xmejkal/sisuo-brain-transplant/(list of files, drawings)

Other design files:
.tscircuit/cache/pcb_C21190-60b98cc2df22e7e51607d3184a920a28.json
