xmejkal/sisuo-brain-transplant/firmware/micropython/smartbin/power.py

"""
Power policies — "what should the bin do while nothing is happening?"

Staying awake and sleeping deeply are not the same program: deep sleep on this chip is a reset,
so "waking" means booting, asking why, and acting on the answer. All of that is confined here,
behind `PowerPolicy`, and `config.POWER_POLICY` picks one. Nothing else in the firmware knows
which is in use — the lid, the state machine and the sensors are identical either way.

Board and port specifics (wake pins, sleep, watchdog) live in board.py.
"""

from . import board, log, states, timing


class PowerPolicy:
    """
    What the application needs from a power policy:

        trigger_for_wake(smart_bin)     the trigger to fire because of how we booted, or None
        await tick_while_idle(bin)      called repeatedly; may sleep the chip and never return
        sleep_now(smart_bin)            sleep immediately, if this policy can

    Policies may read the bin's state, but must not drive the lid themselves.
    """

    name = "policy"
    sleeps = False

    def trigger_for_wake(self, smart_bin):
        return None

    async def tick_while_idle(self, smart_bin):
        raise NotImplementedError

    def sleep_now(self, smart_bin):
        log.warn("power: %s never sleeps", self.name)
        return False


class StayAwakePolicy(PowerPolicy):
    """
    Never sleeps. What you want on USB, on the bench and while calibrating: the REPL stays alive,
    timing is honest, and nothing reboots underneath you.
    """

    name = "always_on"

    async def tick_while_idle(self, smart_bin):
        await timing.async_sleep_ms(smart_bin.config.IDLE_TICK_MS)


class DeepSleepPolicy(PowerPolicy):
    """
    Sleeps the chip once the bin has been idle, waking on the sensor's interrupt or the OPEN
    button.

    The sensor keeps ranging while the chip is off, so the ESP32's own ~15 uA stops being the
    budget and the sensor's ~170 uA at one reading per second takes over.

    The amplifier used to be the other half of this budget and is no longer. A DFR0534 sat
    permanently on the rail with no enable pin, its class idles somewhere around 15-25 mA,
    nobody had measured it, and if it were anywhere near that figure it was roughly forty times
    everything else put together — so no battery-life claim could be made at all.

    Since 2026-09-25 the audio is a MAX98357A whose shutdown pin the firmware drives: 0.6 uA
    held low, against 340 uA if the clock merely stops, and `hardware.enter_safe_state()` drops
    it before every sleep. That is small enough to disappear beside the sensor, which means the
    sensor is now genuinely the budget rather than one of two unknowns.

    Still measured by nobody, and still the honest caveat on any figure quoted here: the
    sensor's own idle draw, and what the module's regulators cost when nothing is running.

    Requirements this policy checks rather than assumes:
      * the sensor must be able to watch while asleep (`SENSOR_STRATEGY = "tof_interrupt"`);
      * every wake pin must be wake-capable — D0/D1/D2 on this board;
      * every wake source must share the polarity in `config.WAKE_ON_HIGH`, because the chip
        applies one level to all of them. A pull-up button (idle high, pressed low) with
        wake-on-high would wake the instant it slept, forever.
    """

    name = "deep_sleep"
    sleeps = True

    def __init__(self, clock=None):
        self._idle_since_ms = None
        self._clock = clock or timing.Clock()

    # ----------------------------------------------------------------- waking
    def trigger_for_wake(self, smart_bin):
        """Turn the reason we booted into a trigger, so a wake acts immediately."""
        if not board.woke_from_sleep():
            log.info("power: cold boot")
            return None

        gpio_numbers = board.wake_gpio_numbers()
        log.info("power: woken by GPIO %s", gpio_numbers or "(port cannot say)")

        if not gpio_numbers:
            return self._trigger_by_reading_pins(smart_bin)

        if smart_bin.config.PIN_BUTTON_OPEN in gpio_numbers:
            return states.OPEN_PRESSED
        if smart_bin.config.PIN_TOF_INTERRUPT in gpio_numbers:
            smart_bin.sensor.acknowledge_wake()
            return states.HAND_DETECTED
        return None

    def _trigger_by_reading_pins(self, smart_bin):
        """
        Fallback for MicroPython builds that report only *that* we woke, not from which pin:
        look at the pins ourselves. The signal is still asserted this early after a wake.
        """
        if smart_bin.hardware.button_open.is_pressed:
            return states.OPEN_PRESSED
        smart_bin.sensor.acknowledge_wake()
        return states.HAND_DETECTED

    # ----------------------------------------------------------------- sleeping
    async def tick_while_idle(self, smart_bin):
        await timing.async_sleep_ms(smart_bin.config.IDLE_TICK_MS)

        if not self._may_sleep(smart_bin):
            self._idle_since_ms = None
            return

        if self._idle_since_ms is None:
            self._idle_since_ms = self._clock.now_ms()
            return

        idle_for_ms = self._clock.elapsed_ms(self._idle_since_ms)
        if idle_for_ms >= self._sleep_after_ms(smart_bin):
            self.sleep_now(smart_bin)

    def _may_sleep(self, smart_bin):
        """
        A faulted bin sleeps too, just later: blinking red until the cell is flat helps nobody,
        and waking on the button is how the fault gets cleared anyway.
        """
        return smart_bin.lid.state in (states.IDLE, states.FAULT)

    def _sleep_after_ms(self, smart_bin):
        if smart_bin.lid.state == states.FAULT:
            return smart_bin.config.SLEEP_AFTER_FAULT_MS
        return smart_bin.config.SLEEP_AFTER_MS

    def sleep_now(self, smart_bin):
        """
        Put everything in its resting state, arm the wake pins, and stop the chip. Does not
        return — unless it refuses, which it does rather than sleep with no way back.

        A bin that sleeps with nothing able to wake it is dead until someone unplugs it. That is
        a worse outcome than a flat battery, so every reason to refuse is checked here.
        """
        config = smart_bin.config
        sensor_can_wake = smart_bin.sensor.arm_for_sleep()

        if not self._wake_sources_can_assert(smart_bin, sensor_can_wake):
            return False

        smart_bin.hardware.enter_safe_state()
        wake_gpio = self.wake_gpio_numbers(config, smart_bin.sensor)
        log.info("power: sleeping, wake on GPIO %s", wake_gpio)
        board.deep_sleep(wake_gpio, wake_on_high=config.WAKE_ON_HIGH)
        return True

    def _wake_sources_can_assert(self, smart_bin, sensor_can_wake):
        """
        Can anything actually wake this bin?

        The chip applies one polarity to every wake pin, so a source whose asserted level is the
        opposite of `WAKE_ON_HIGH` is not a wake source at all — it is a pin that will sit there.
        A button wired to ground asserts LOW; the sensor's interrupt is configured to match
        whichever polarity is chosen.
        """
        config = smart_bin.config
        button_asserts_high = smart_bin.hardware.button_open.pressed_level == 1

        reasons = []
        if button_asserts_high != config.WAKE_ON_HIGH:
            reasons.append(
                "the OPEN button asserts %s but wake is armed for %s"
                % ("HIGH" if button_asserts_high else "LOW",
                   "HIGH" if config.WAKE_ON_HIGH else "LOW")
            )
        if not sensor_can_wake:
            reasons.append("the sensor cannot watch while asleep (%s)" % config.SENSOR_STRATEGY)

        if len(reasons) > 1 or (reasons and not sensor_can_wake and button_asserts_high != config.WAKE_ON_HIGH):
            log.error("power: refusing to sleep, nothing could wake the bin: %s", "; ".join(reasons))
            return False
        for reason in reasons:
            log.warn("power: %s", reason)
        return True

    @staticmethod
    def wake_gpio_numbers(config, sensor):
        """Which pins are armed. Separate from `sleep_now` so a test or the REPL can check it."""
        numbers = [config.PIN_BUTTON_OPEN]
        if sensor.watches_while_asleep:
            numbers.append(config.PIN_TOF_INTERRUPT)
        board.assert_wake_capable(numbers)
        return numbers


POLICIES = {
    StayAwakePolicy.name: StayAwakePolicy,
    DeepSleepPolicy.name: DeepSleepPolicy,
}


def build_policy(config):
    """The strategy choice, from one config line. An unknown name stays awake, loudly."""
    policy_class = POLICIES.get(config.POWER_POLICY)
    if policy_class is None:
        log.warn("unknown power policy %r; staying awake", config.POWER_POLICY)
        return StayAwakePolicy()
    return policy_class()
