xmejkal/sisuo-brain-transplant/firmware/micropython/smartbin/close_detection.py

"""
Close detection — "is the lid actually shut?"

This is the question the original Sisuo board got wrong: it drove the lid closed and waited
forever for a confirmation that never came. `CloseDetector` is the question; the three
implementations are increasingly good answers, chosen by `config.CLOSE_DETECTOR`.

None of them is the safety net. `Lid` stops the motor at `MOTOR_MAX_RUN_MS` regardless of what a
detector says, so a broken detector can never burn the motor.
"""

from . import log


class CloseDetector:
    """
    What the lid needs to know whether a closing stroke has finished:

        start()                called as the closing stroke begins
        is_closed(elapsed_ms)  True when the lid should be considered shut;
                               `elapsed_ms` is measured from the start of that stroke
    """

    def start(self):
        """Reset any per-stroke state. Detectors with none may do nothing."""

    def is_closed(self, elapsed_ms):
        raise NotImplementedError


class TimedCloseDetector(CloseDetector):
    """
    Run the motor for a calibrated time and call it shut. No extra hardware, no feedback.

    Good enough to get the bin working, and the reason `LID_CLOSE_RUN_MS` needs calibrating on
    the bench. It cannot tell "shut" from "jammed on a bin bag" — that is what the safety cap and
    the OBSTRUCTED state are for.
    """

    def __init__(self, run_ms):
        self._run_ms = run_ms

    def is_closed(self, elapsed_ms):
        return elapsed_ms >= self._run_ms


class LimitSwitchCloseDetector(CloseDetector):
    """
    A microswitch at the end of travel: deterministic, no calibration, and "shut" means shut.
    One extra part, and the option the electronics review preferred.

    The switch is wired to ground with a pull-up, so a closed switch reads 0.
    """

    def __init__(self, pin):
        self._pin = pin

    def is_closed(self, elapsed_ms):
        return self._pin.value() == 0


class MotorStallCloseDetector(CloseDetector):
    """
    Watch the motor current and call the lid shut when it stalls against its stop — the method
    the original board appears to have used.

    Needs the 1 ohm shunt in the motor's ground return and an ADC pin (only GPIO0/1/2 have one on
    this chip). Readings are averaged because the ESP32-C6's ADC is noisy, and the first
    `blanking_ms` of a stroke are ignored so the motor's inrush current is not read as a stall.

    `consecutive_hits` counts polls rather than time, so it depends on `MOTION_POLL_MS`; at the
    default 10 ms, 3 hits is about 30 ms of sustained over-current.
    """

    def __init__(self, adc, stall_counts, blanking_ms=200, samples=8, consecutive_hits=3):
        self._adc = adc
        self._stall_counts = stall_counts
        self._blanking_ms = blanking_ms
        self._samples = samples
        self._consecutive_hits = consecutive_hits
        self._hits = 0

    def start(self):
        self._hits = 0

    def read_counts(self):
        """Averaged raw ADC counts. Public because calibration reads it from the REPL."""
        total = 0
        for _ in range(self._samples):
            total += self._adc.read_u16()
        return total // self._samples

    def is_closed(self, elapsed_ms):
        if elapsed_ms < self._blanking_ms:
            return False

        counts = self.read_counts()
        if counts < self._stall_counts:
            self._hits = 0
            return False

        self._hits += 1
        if self._hits < self._consecutive_hits:
            return False

        log.info("stall detected at %d counts after %d ms", counts, elapsed_ms)
        return True
