xmejkal/sisuo-brain-transplant/tools/build-flash-image.py

#!/usr/bin/env python3
"""
Build a flash image containing MicroPython *and* our firmware, for headless simulation.

The problem this solves: Wokwi's CLI simulates a flash image, and the MicroPython download is
only the interpreter. On real hardware you copy your .py files over USB afterwards; a headless
simulator has no "afterwards". So the files have to already be in the image.

MicroPython's ESP32 partition table stops after `factory`, and the comment in its own
partitions-4MiBplus.csv says the rest of the flash is the user filesystem — so the filesystem
starts at 0x200000 and runs to the end of a 4 MB flash. This writes a littlefs image of our
firmware there and concatenates the two.

    python3 tools/build-flash-image.py
    python3 tools/build-flash-image.py --config '{"POWER_POLICY": "deep_sleep"}' other.bin

The second form writes a /config.json into the image, which is how a differently-configured bin
is simulated without editing config.py.

The littlefs parameters are the ones MicroPython's ESP32 port uses. If they are wrong the
simulated board boots to a bare REPL with no main.py, which is the symptom to look for.
"""

import json
import sys
from pathlib import Path

from littlefs import LittleFS

REPO = Path(__file__).resolve().parent.parent
FIRMWARE = REPO / "firmware" / "micropython"
SIM = FIRMWARE / "sim"

# The active board, as spark's boards.py resolved and validated it — the same file
# tools/generate-board-spec.py reads. This imported spark's `boards` to ask two questions the
# resolved file already answers, which made the image builder, and the gate that imports it,
# unable to run anywhere spark is not: CI, which cannot reach the private plugin (spark B7).
RESOLVED_BOARD = json.loads((REPO / ".spark" / "board.json").read_text())

# Named after the chip, not hard-coded: the Makefile guards this target on a file called
# micropython-<chip>.bin, and a constant here that named a different chip made the guard pass
# and the script then fail looking for the previous board's build. Which is exactly what
# happened when the board changed from an ESP32-C6 to an S3.
MICROPYTHON_IMAGE = SIM / ("micropython-%s.bin" % RESOLVED_BOARD["chip"])
MICROPYTHON_PORT = RESOLVED_BOARD["micropython_port"]
OUTPUT_IMAGE = SIM / "flash-with-firmware.bin"

# Settings written into /config.json inside the image. Only keys in config.CALIBRATABLE are
# accepted by the firmware.
#
# The MAIN simulation image is the BENCH configuration: awake, polling the rangefinder over I2C.
# This was `{}` until 2026-09-25, which inherited config.py's deployed defaults — deep_sleep and
# tof_interrupt — so the bin under test slept and let the sensor range by itself. Two scenarios
# could therefore never pass, and never had: `wave-to-open` and `obstruction` both drive the
# sensor's distance control and wait for the lid to react, which a sleeping bin with a
# self-ranging sensor does not do. Both timed out at "smartbin ready" for the life of the file.
#
# The battery configuration is not lost: it has its own image and its own project directory,
# because a wokwi.toml names exactly one firmware. See sim/deep-sleep/.
CONFIG_OVERRIDES: dict = {"POWER_POLICY": "always_on", "SENSOR_STRATEGY": "tof"}

FLASH_SIZE = 4 * 1024 * 1024        # the XIAO ESP32-C6 has 4 MB
FILESYSTEM_OFFSET = 0x200000        # where MicroPython looks, per partitions-4MiBplus.csv
BLOCK_SIZE = 4096

# MicroPython's own littlefs2 settings, read from its source rather than guessed:
#   extmod/vfs_lfs.c   readsize / progsize / lookahead all default to 32
#   extmod/vfs_lfsx.c  cache_size = min(block_size, 4 * max(read, prog)) = 128, block_cycles = 100
# These must match or the board mounts nothing, boots to a bare REPL, and never runs main.py.
LITTLEFS_SETTINGS = dict(
    block_size=BLOCK_SIZE,
    read_size=32,
    prog_size=32,
    cache_size=4 * 32,
    lookahead_size=32,
    block_cycles=100,
    disk_version=0x00020000,        # littlefs 2.0, which MicroPython writes
)

# What goes on the simulated board: the package, its configuration, and the two boot files.
def files_to_include():
    yield from sorted((FIRMWARE / "smartbin").glob("*.py"))
    yield FIRMWARE / "config.py"
    yield FIRMWARE / "main.py"
    yield FIRMWARE / "boot.py"


def build_filesystem(overrides: dict) -> bytes:
    block_count = (FLASH_SIZE - FILESYSTEM_OFFSET) // BLOCK_SIZE
    filesystem = LittleFS(block_count=block_count, **LITTLEFS_SETTINGS)
    filesystem.mkdir("/smartbin")

    total = 0
    for source in files_to_include():
        destination = (
            f"/smartbin/{source.name}" if source.parent.name == "smartbin" else f"/{source.name}"
        )
        content = source.read_bytes()
        with filesystem.open(destination, "wb") as handle:
            handle.write(content)
        total += len(content)
        print(f"  {destination:<28} {len(content):>6} bytes")

    if overrides:
        content = json.dumps(overrides).encode()
        with filesystem.open("/config.json", "wb") as handle:
            handle.write(content)
        total += len(content)
        print(f"  {'/config.json':<28} {len(content):>6} bytes  {overrides}")

    print(f"  {'':<28} {total:>6} bytes in {block_count} blocks of {BLOCK_SIZE}")
    return filesystem.context.buffer


def main() -> int:
    if not MICROPYTHON_IMAGE.exists():
        print(f"missing {MICROPYTHON_IMAGE}")
        print("download a build from https://micropython.org/download/%s/" % MICROPYTHON_PORT)
        return 1

    overrides = dict(CONFIG_OVERRIDES)
    output = OUTPUT_IMAGE
    arguments = sys.argv[1:]
    if "--config" in arguments:
        index = arguments.index("--config")
        overrides = json.loads(arguments[index + 1])
        output = SIM / arguments[index + 2] if len(arguments) > index + 2 else OUTPUT_IMAGE

    print("firmware files:")
    filesystem = build_filesystem(overrides)

    interpreter = MICROPYTHON_IMAGE.read_bytes()
    if len(interpreter) > FILESYSTEM_OFFSET:
        print(f"the MicroPython image is larger than {FILESYSTEM_OFFSET:#x}; it would be overwritten")
        return 1

    image = bytearray(b"\xff" * FLASH_SIZE)
    image[: len(interpreter)] = interpreter
    image[FILESYSTEM_OFFSET : FILESYSTEM_OFFSET + len(filesystem)] = filesystem
    output.write_bytes(image)

    print(
        f"\nwrote {output.relative_to(REPO)}: "
        f"{len(image) // 1024} KB "
        f"(MicroPython to {len(interpreter):#x}, filesystem at {FILESYSTEM_OFFSET:#x})"
    )
    return 0


if __name__ == "__main__":
    sys.exit(main())
