xmejkal/sisuo-brain-transplant/(commit log)

2026-09-22 Smart bin: routed board (real parts) + firmware + docs + parts reference
    [oled_ssd1306.obj, pcb_C14663-2a524d5328448d9a4ab8c2511452e7b5.json, pcb_C23162-1be90e176d4cbb49a1eca76dfaf2f7c9.json, tactile_button_6mm.obj]
2026-09-23 Firmware v2: MicroPython state machine, strategies, tests
    Replaces the v1 timed loop with an OO package built around an explicit state
    machine, after a MicroPython/ESP32 architecture review and a digital-electronics
    review of the planned hardware.
    - states.py holds states, triggers and the transition table - behaviour as data,
    so obstruction handling (reopen, retry, then latch a fault) is readable and
    testable. The original bin's fault was retrying a close forever.
    - Strategy pattern where the hardware is undecided: proximity sensing (VL6180X
    ToF / IR burst / buttons only) and close detection (timed / limit switch /
    stall). Both chosen in config.py.
    - Events are "entered:<state>", p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
    [01_board_alive.py, 02_inputs.py, 03_tof.py, 05_motor.py, app.py, audio.py, boot.py, config.py]
2026-09-23 Deep sleep support: power policies, interrupt-driven ToF, new pin map
    Adds the seam that makes "polling vs interrupts vs deep sleep" a config line
    instead of a rewrite, after verifying what the C6 actually supports.
    - power.py: AlwaysOnPolicy (bench/USB) and DeepSleepPolicy, behind prepare()/
    idle(). Waking from deep sleep is a reset, so prepare() converts the wake pin
    into a trigger and the hand that woke the bin does not wave twice.
    - sensors.TofInterruptSensor: the VL6180X ranges continuously on its own clock
    and asserts GPIO1 below a threshold, so the CPU can be off entirely. While
    awake it reads the pin rather than the I2C bus.
    - vl6180x: configure_interrupt/start_continuous/cl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
    [02_inputs.py, 03_tof.py, app.py, config.py, power.py, sensors.py, vl6180x.py]
2026-09-23 Audit fixes: self-cancelling tasks, sensor errors, naming, calibration
    A four-way review (correctness, readability, architecture, on-device
    practicality) went through the firmware. The critical finding first.
    CRITICAL: MicroPython raises RuntimeError("can't cancel self") when a task
    cancels itself, and every stroke does exactly that - it fires the trigger that
    transitions the lid away, and the exit hook cancels the running stroke. The lid
    would have opened once and frozen forever, with the machine stuck mid-transition.
    Fixed in lid._cancel_safely; the test fakes now model the RuntimeError instead of
    swallowing it, and a new test runs the real lid against real asyncio, because a
    model of asy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
    [app.py, audio.py, boot.py, config.py, events.py, factory.py, fakes.py]
2026-09-23 Make smartbin/__init__.py the guided tour of the firmware
    The entry path was spread across four files, so "how does this work" had no
    single answer. The package docstring is now the tour: what each part is, a
    diagram of how they connect, and the end-to-end walkthrough of a hand wave
    through sensor, trigger, table, hook, stroke and feedback.
    build() reads top to bottom as the assembly itself - peripherals, then the three
    swappable decisions, then the things that react, then the object that runs it.
    app.py -> smart_bin.py, since it defines SmartBin, and main.py and the README now
    point at the tour.
    [main.py, smart_bin.py]
2026-09-23 Sort the layering: devices in hardware, decisions in strategies
    "Why is the motor hardware but the sensor is not?" had no good answer, because
    the rule was never stated and had drifted: hardware held some device objects
    (motor, player, buttons) and some raw pins, while the VL6180X driver - a device
    by any reading - was constructed in factory.py next to the strategy choices.
    The rule now: a DEVICE is a thing you command, a STRATEGY is a decision you make
    with it. So the rangefinder chip sits in hardware.py beside the motor, and "is
    that a hand?" stays in sensors.py, because which judgement you want is a config
    choice and the chip is not.
    - hardware.py builds the rangefinder (with its calibr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
    [factory.py, hardware.py, test_factory.py]
2026-09-23 Rename modules for clarity; one composition root
    Names now say the job rather than the pattern or the acronym, and "how is a bin
    assembled" has a single answer.
    factory.py -> assembly.py (names the job; now also holds build/run)
    fsm.py -> state_machine.py (no acronyms)
    ui.py -> buttons.py + status_led.py (there is no UI; two devices, two files)
    closing.py -> close_detection.py (a gerund that read like shutdown)
    compat.py -> timing.py (ticks, clocks and sleeps, not miscellany)
    platform.py -> board.py (platform shadows a stdlib module - a real trap)
    sensors.py -> proximity.py (says what it senses)
    build() and run()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
2026-09-23 Testing: a fake machine module, and Wokwi simulation scaffolding
    Two new layers between the unit tests and the bench.
    tests/fake_machine.py stands in for MicroPython's machine and esp32 modules, so
    hardware.py, the VL6180X driver's register conversation and the real asyncio
    tasks all run on the Mac. test_on_fake_hardware.py uses it to press a button and
    watch the motor pins, wave a hand past a fake rangefinder, assert that
    constructing the bin never moves the lid, and check that deep sleep arms the
    right wake pins and stops the motor first. 58 tests now, still under two seconds.
    sim/ holds the Wokwi setup. Researched and verified: Wokwi supports the ESP32-C6
    and the XIAO ESP32-C6 is a stoc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
2026-09-23 Simulate on MicroPython, and fix the bug it found
    sim/run_on_micropython.py runs the whole firmware on a real MicroPython runtime
    (brew install micropython) with tests/fake_machine.py underneath it: it presses
    the buttons, waves a hand at the rangefinder, holds something in the lid's way,
    and checks what the bin does. Twelve checks, exit code says pass or fail, no
    account and no cloud. Every module also compiles clean under mpy-cross, which is
    MicroPython's own compiler.
    It found a real bug on its first run. A hand that never leaves re-armed the hold
    timer forever - "a hand in the way keeps the lid open" was deliberate, but nothing
    capped the total, so anything parked in front of the sensor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
    [config.py, fakes.py, lid.py, state_machine.py, test_integration.py, test_lid.py]
2026-09-23 Add a README for the repository
    Written for someone landing on the project cold: what it is, what is proven and
    what is not, how the lid behaves, and how to run the tests and the simulation.
2026-09-23 Wokwi: custom chips for the parts it has no model of
    Wokwi has no time-of-flight sensor and no H-bridge, which are exactly the two
    parts the bin's behaviour depends on, so both are now written as custom chips in
    C and compile to WASM with wokwi-cli.
    - vl6180x.chip.c answers I2C at 0x29 with the registers smartbin/vl6180x.py
    actually reads: model ID, fresh-out-of-reset, sample-ready, range and status.
    The measured distance comes from a slider you can drag mid-simulation, and the
    interrupt pin asserts below the threshold the firmware sets - so the wake-on-
    hand path is simulable too.
    - l9110s.chip.c watches the driver's two inputs and prints MOTOR: opening /
    closing / stopped, which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
    [l9110s.chip.c, vl6180x.chip.c]
2026-09-23 Plan the conversion pipeline from circuit.json to other formats
    Researched what a standard interchange format actually is (there isn't one),
    what already exists (a lot, from tscircuit and kicad-cli) and what has to be
    written (only the Wokwi converter - nothing anywhere converts an EDA format to
    diagram.json).
    The design: circuit.json stays the pivot, a thin logical netlist is the one
    shared abstraction, and every target is a pure emitter reading it. Connectivity
    is read one way only, through the precomputed subcircuit_connectivity_map_key
    that every source_port already carries. Anything mature is delegated to KiCad,
    so we maintain two converters instead of six.
    Also records what must stay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
2026-09-23 Build circuit-to-wokwi: generate the simulation from the board design
    Nothing converts an EDA format to Wokwi's diagram.json, so this does. The design
    is the one planned in FORMATS.md: circuit.json -> a thin Netlist -> emitters,
    with the mapping table as data and connectivity read only through
    circuit-json-to-connectivity-map, never re-derived.
    What research changed:
    - @wokwi/diagram-lint bundles Wokwi's own registry of 137 parts with real pin
    lists, so pin names are checked offline rather than guessed. It immediately
    caught board-ssd1306 using SDA/SCL where I had written DATA/CLK.
    - Custom chips are in neither that registry nor wokwi-cli lint, so the oracle
    also reads our chip.json f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
2026-09-23 Board v2, and a Makefile so everything derived stays derived
    The board was the odd one out: board.tsx still described the v1 design (TB6612,
    OLED, old pin map) while the firmware and the simulation had moved on. It now
    describes what the firmware expects - L9110S, a time-of-flight rangefinder on
    I2C, a bicolour status LED, no OLED, and the v2 pin map that keeps the sensor
    interrupt, the OPEN button and the one ADC on D0/D1/D2, the only pins that can
    wake an ESP32-C6. It builds and routes clean: 45 traces, no errors. The v1 design
    is kept as board-v1-tb6612.tsx.
    Also on the board now, from the electronics review: 10k pulldowns holding the
    motor still while the board boots, a 1 ohm low-side s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
    [pcb_C23138-15214603cfbb15bb8920109fa7e6863a.json, pcb_C25271-413a824410202a5aed057ecaefafa0a3.json, pcb_C25804-fb8d950806824786da1b1e4ced4e126a.json]
2026-09-23 The generated diagram is now the diagram the simulator loads
    It was being written to diagram.generated.json beside a hand-written
    diagram.json, and Wokwi loads diagram.json - so the generated file was doing
    nothing and the two could disagree freely, which is the exact failure this tool
    exists to prevent.
    Now board.tsx generates sim/diagram.json itself. The hand-written version is in
    git history; its layout is not carried over because the part ids come from the
    design (BtnOpen -> btnopen), and from here on merge.ts preserves any positions
    tuned in the editor.
    The scenario file follows the same ids. Verified: the result passes Wokwi's own
    wokwi-cli lint, wires all eight parts including both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
2026-09-23 Verify the two facts the first simulation run depends on
    Both were guesses; both are now read from source rather than assumed.
    littlefs: MicroPython's defaults are readsize/progsize/lookahead = 32
    (extmod/vfs_lfs.c) and cache_size = min(block_size, 4*max(read, prog)) = 128 with
    block_cycles = 100 (extmod/vfs_lfsx.c). That is exactly what the image builder
    uses, so the "boots to a bare REPL with no main.py" failure is now unlikely
    rather than merely hoped against. The reference is in the file so nobody
    re-derives it.
    set-control: the current field is `name`, and the docs still show `control`,
    which the CLI accepts as a deprecated alias
    (packages/cli/src/scenario/SetControlCommand.ts). The s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
    [build-flash-image.py]
2026-09-23 The simulation runs: a press drives a full lid cycle
    make simulate now exits 0 with "Scenario completed successfully". Our MicroPython
    firmware boots on a simulated ESP32-C6 from the flash image we build, a simulated
    button press opens the lid, the motor chip reports it turning, the hold expires,
    and it closes itself. The strokes measured 912 ms and 951 ms against the 900 and
    950 configured.
    Four things were wrong, each costing one run:
    - wait-serial watches the MCU's serial only. A custom chip's printf goes to a
    separate stream, shown prefixed, and can never match a wait-serial. Two of the
    failures were exactly this, on MOTOR: lines.
    - a wait only sees text arriving after its step beg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
    [l9110s.chip.c]
2026-09-23 One file describes the board; everything else derives from it
    "Is changing the ESP easy and in one place?" It was not: the silkscreen-to-GPIO
    map, the wake-capable pins, the Wokwi part type and the board's size lived in six
    places across the firmware, the PCB design, the converter and two checkers. Six
    copies of a fact are five chances to be wrong.
    boards/xiao-esp32-c6.json is now the single description: pins, wake-capable
    GPIOs, ADC pins, pins with a second job, the deep-sleep API this chip actually
    has, and - because a board swap has to refresh the shape too - its footprint,
    outline and on-screen size.
    Derived from it: the firmware's board_spec.py (generated; make check fails when
    stale)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
    [board.py, build-flash-image.py, generate-board-spec.py, vl6180x.chip.c]
2026-09-23 Make the checks able to fail, and stop committing 12 MB of binaries
    An audit found the headline guarantee was false: `make check` could not fail on
    the two checks that compare the firmware, the board and the simulation. Both
    recipes ended in `| tail -1`, and a shell reports only the last command's status,
    so a failing check printed its complaint and then "everything is in step" with
    exit 0. CI and the pre-commit hook waved it through.
    .SHELLFLAGS with pipefail would fix it on GNU make 3.82+; macOS ships 3.81, which
    ignores it. So every gating recipe now runs bare, captures output to a file, and
    prints from there - the pattern the test steps already used.
    Verified by breaking things on purp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
2026-09-23 Safety fixes from the audit: wake polarity, config validation, task supervision
    Three findings that would have cost a bench day each, and a fourth that would
    have cost the battery.
    The OPEN button could never have woken the bin. The board wires both buttons to
    ground, so they assert LOW, while the firmware armed ext1 for a HIGH and pulled
    the pin down - a pin held low, waiting to go high. Worse, two tests asserted the
    two halves of that contradiction and both passed. The board now owns the
    polarity (boards/*.json), the button carries its own pressed_level, and the power
    policy refuses to sleep when nothing armed could assert the level that wakes -
    because a bin asleep with no way back is wo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
    [buttons.py, config.py, lid.py, power.py, smart_bin.py, test_on_fake_hardware.py]
2026-09-23 Converter: stop parts vanishing, and let the mapping own its attributes
    Two holes the audit opened with a screwdriver.
    Unanchored skip patterns swallowed parts they were never meant to. /Power/
    matched a component renamed from StatusLed to PowerLed, and the status LED left
    the simulation in silence with "the simulator powers the board itself" - exit 0,
    coverage clean. Every skip rule is now anchored to whole component names, and a
    new check requires every component in the design to become a part, a stated
    omission or a reported problem. Verified with the same rename: it now fails.
    Attributes were write-once. merge.ts let the committed file's attrs override the
    generated ones, so changing a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
2026-09-23 Documentation sweep: make every claim true
    An audit checked every factual claim in the docs against the code and found the
    project describing itself as it was two days ago. The worst of it:
    - README and STATUS said the PCB was still v1 (TB6612, OLED, old pin map). It is
    v2, routed, 45 traces, 0 errors, and matches the firmware pin for pin.
    - STATUS said the Wokwi project had never been run, three commits after it ran
    and four scenarios passed.
    - The chips README said "not written yet" about two chips that are compiled and
    in use - and said nothing about how they diverge from the real parts, which is
    what a reader actually needs.
    - CLAUDE.md carried a v1 pin map alongside the v2 one,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
2026-09-23 An empty room is not a broken sensor
    The firmware counted a routine measurement error toward its failure budget. An
    empty field of view produces one every time - the driver's own docstring says so -
    so a bin nobody was using would have faulted after ten polls, about six hundred
    milliseconds, and sat there with a red LED until someone pressed a button.
    Nothing caught it because both fakes always reported a good reading. Now they can
    fail in both ways, and the two cases are distinguished: a measurement error means
    "no hand" and resets the count, while a silent bus escalates to a fault after ten
    tries, because a cable that comes out must be noticed.
    Sixteen new tests, covering what the audit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
    [fake_machine.py, proximity.py, test_audio_and_feedback.py, test_sensor_failure.py]
2026-09-23 Board and simulator fixes: sense filter, and a chip that can fail
    The remaining audit findings.
    The pulldowns on the motor inputs returned to system ground while the driver's
    own ground sits a shunt-drop above it - so while the motor ran, the "low" the
    driver saw was negative with respect to its own ground, outside its input range
    and an injection path into the chip. They now return to the driver's ground.
    The shunt is 0.33 ohm rather than 1: it still gives ~76 mV at the stall the
    literature predicts, comfortably above this ADC's noise, while costing the motor
    a third of the voltage. The sense line reaches the pin through 1k and 100nF,
    which limits current into the pin if the motor ever st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
    [pcb_C21190-60b98cc2df22e7e51607d3184a920a28.json]
2026-09-23 Tests and harnesses pin the configuration they describe
    Found by asking the obvious question: what happens if someone changes the sensor?
    Switching SENSOR_STRATEGY to "ir" - one line, exactly the seam the strategies
    exist for - broke seven tests and the MicroPython harness. Not because the
    firmware minded, but because those files copied whatever config.py shipped with
    and then asserted things about the rangefinder. A file that tests the
    time-of-flight build should say so, not inherit it.
    They now pin SENSOR_STRATEGY, CLOSE_DETECTOR and POWER_POLICY explicitly.
    Changing the shipped default no longer makes them fail; it makes them irrelevant,
    which is what a test about a different build shou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
    [test_on_fake_hardware.py, test_sensor_failure.py]
2026-09-23 Real module bodies, and only for what is really on the board
    The board carried real footprints but nothing said how big the things that plug into them
    are. A six-pin header is 15 x 2.5 mm; the driver that sits on it is 29 x 23 and stands 12 mm
    tall. So every module now carries a 3D body at its true size — vendor STEP where one exists
    (L9110S, CC0), the vendor's own dimension drawing where it does not (DFR0534, 30 x 22 mm),
    and the module outline for the XIAO, which Seeed publish no model for.
    That immediately showed eight collisions and four parts hanging off the edge, none of which
    any PCB check had objected to, because pads were never the constraint.
    The fix was not a bigger board. Two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
    [check-module-clearance.py]
2026-09-23 A bring-up step that runs the whole bin, and is itself checked
    Steps 1 to 5 prove one part each; nothing proved the assembled bin until you deployed the
    firmware and improvised at the REPL. Step 6 is that missing step, written down: it runs the
    real build() with the real strategies, does a roll call of every fitted device before anything
    moves, then asks for a wave, an OPEN press and a MODE press, and reports which of the three
    ways in worked. Per-phase, because "it doesn't work" is not a useful bench result.
    The script is checked off the bench. tests/test_bringup.py runs it against the fake chip with
    a stand-in for the person, supplying only the stimulus each phase asks for — so a "wave"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
    [06_all_together.py, test_bringup.py]
2026-09-23 Documentation: make the counts true again
    80 tests not 79, 13 MicroPython checks not 12 (make counted 13 while three documents said
    12), 48 traces not 45, and the handover note now ends the bring-up list where it actually
    ends: at step 6, the acceptance test.
2026-09-24 Three defects an expert audit found, two of which stop the bin working
    A council of reviewers was asked to audit a plan for a new plugin. The plan did not survive,
    but the audit found something better: three defects in this design, sitting in a repo where
    every generated artifact agreed with every other one.
    **The battery did not power the MCU.** LipoBattery.POS went to net.VBAT, and VBAT reached the
    MP3 module, its reservoir cap and its decoupling cap — and nothing else. CLAUDE.md has said
    "logic+audio on a LiPo (XIAO BAT pads)" since v2 was designed. The intent was recorded, the
    trace never existed. On battery the ESP32 had no power at all.
    The pads are pin23/pin24 of the footprint, un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
2026-09-24 Board pin roles: typed for programs, noted for people
    `special` was a free-text map — `"16": "U0TXD - the ROM bootloader prints its log here on every
    reset. Safe for a button, never for a module that parses serial."` That sentence contains a real
    design rule, and no program could ever act on it. Only the keys were machine-readable, and only
    one checker used them, as a bare set of numbers.
    It is now `pin_roles`: named roles (`boot_log_tx`, `onboard_led`), each with a `gpio` array a
    check can read and the note kept intact for whoever is reading the file. The spark plugin's new
    pin check uses it to fail a UART module placed on the boot-log pin while still allowing a button
    there, which is th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
    [generate-board-spec.py]
2026-09-24 L9110S input thresholds: measured off the datasheet, and what they cost
    The audit flagged a question it could not answer: the L9110S runs on 6 V and its inputs are
    driven from 3.3 V GPIO, so if its input-high threshold were ratiometric (0.7 x VCC = 4.2 V) the
    motor would never turn. Pulled the datasheet and read the table: VH in is 2.5 V min, 5.0 typ,
    9.0 max — an absolute voltage. 3.3 V logic drives it. The worry does not apply to this part.
    But the same numbers expose something the design does have to live with. The driver's ground
    sits on net.MOTOR_SENSE, above system ground by I x 0.33 R, and the chip judges its inputs
    against its own ground. So the effective input high is 3.3 - 0.33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
2026-09-24 Stop the docs promising a battery life nobody has measured
    Two files told you, after a break, that this bin runs for months on a 1000 mAh cell:
    smartbin/power.py's DeepSleepPolicy docstring and firmware/micropython/README.md. Both arrive at
    that by budgeting only the parts the sleep policy can switch off — the sensor at ~170 uA and the
    ESP32 at ~15 uA — and neither mentions the DFR0534.
    The MP3 module sits on VBAT permanently with no enable pin. Its class idles somewhere around
    15-25 mA, which would be roughly forty times everything else on the board put together, and would
    make both statements wrong by a similar factor. Nobody has measured this one, so the honest
    position is that the b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
    [audio.py, power.py]
2026-09-24 The bin gets a brief and a findings file
    .spark/project.json says what this thing must do — a month on a charge, fit the original cavity,
    open within half a second — plus what is already decided, so a reviewer stops relitigating the
    L9110S and the missing OLED. The `must` list is what turns a number into a finding: "15 mA idle"
    is a measurement, "15 mA idle against a stated one-month requirement" is something to act on.
    .spark/findings.json carries the two real findings the reviews have produced so far: the
    always-powered MP3 module, and the 0.33R shunt in an 0805 whose 0.125 W rating caps it around
    0.61 A — which the motor may well exceed at stall, in the driver's own ground return.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
2026-09-24 Remove a measurement nobody took
    18.4 mA sat in this project's findings store as the MP3 module's idle current, with an
    instrument and a date, looking exactly like a reading. It was the example value out of the
    plugin's own documentation, pasted in while demonstrating the tool. STATUS.md item 6 correctly
    said the number had never been measured; the store disagreed and the store looked authoritative.
    Both findings go back to blocked, which is what they are.
2026-09-24 Tie the motor driver's unused channel down
    A comparator reading the built netlist reported MotorDriver.BIA and BIB connected to nothing.
    Channel B is unused — one motor, one channel — but its inputs are still inputs on a chip that is
    powered, and a floating CMOS input has no defined level. It drifts, and on an H-bridge an
    undefined input is how both halves of a bridge end up conducting at once.
    Tied to the driver's own ground rather than the board's, matching what the channel A pulldowns
    already do: the shunt lifts the driver's GND above system ground, so an input judged against
    system ground is judged against the wrong reference. Both inputs low is the L9110's coast state,
    which is wha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
2026-09-24 Choose the board in one place, and enforce a contract on it
    boards/active.json now names the active board and nothing else does.
    The Makefile, the firmware's board-spec generator and the simulator's
    diagram generator all resolve through tools/boards.py, which also
    enforces a contract: a board file that breaks it is refused rather than
    read optimistically, because the failure mode of guessing is a wrong
    pin map and that is silent until the hardware is built.
    --validate --for-fab is kept separate and gates gerber export, so
    firmware work proceeds on a board whose footprint nobody has verified
    while an unverified footprint cannot reach a fab file.
    The contract also mechanises the rule boards/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
    [generate-board-spec.py]
2026-09-24 A FireBeetle footprint, generated rather than downloaded
    Every pin position on this module is an obround pad: a through-hole
    1.27 mm inboard of the edge, plus a castellated half-hole centred ON
    the edge. Measure the outer circles and the rows are 25.40 mm apart;
    measure the holes a header actually solders into and they are 22.86 mm.
    At least one public KiCad footprint for this board uses the former, and
    a header fitted to that will not mate. Generating it from DFRobot's
    dimension drawing makes that distinction explicit and reviewable.
    Two mistakes this file now records rather than repeats. The drill was
    0.9 mm, copied straight from DFRobot's drawing — but that is THEIR
    finished hole for T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
    [generate-firebeetle-footprint.py]
2026-09-24 Board v3: the FireBeetle, and what a review found on it
    100 x 62 mm. The module alone is 25.4 x 60 and runs the whole left
    half, which is why the outline grew twice: at 45 mm the two plug-in
    modules stacked to exactly the board height, and at 50 mm there was no
    corner a mounting hole could go in without landing under the module.
    The LiPo now plugs into the module's own socket, so the battery
    connector and the XIAO's BAT-pad polarity question are both gone. There
    is no VBAT rail: the module's 3V3 is a TPS62A02 buck good for 2 A, and
    the MP3 sat on VBAT only because the XIAO's LDO could not take audio
    transients.
    What a four-reviewer pass changed, in order of what it would have cost:
    - 22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
2026-09-24 Firmware for the S3: a new pin map, a switched amplifier, and a crash
    The C6 could wake from three usable pins and the whole map was bent
    around them. The S3 has 22, so pins are spent on purpose: the two that
    must wake the bin take RTC pins that are NOT on ADC1, so they cost no
    analogue headroom; the two that never wake take the non-RTC pins; both
    strapping pins are left empty, because a button on GPIO0 held during a
    reset drops the board into the bootloader.
    Deep sleep is the shipped default, with tof_interrupt alongside it —
    they only work together, because a sleeping chip cannot poll a bus.
    A real crash, on the shipped sensor path: SelfRangingTimeOfFlightSensor
    called _note_failure, w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
    [board.py, config.py, hardware.py, proximity.py, smart_bin.py]
2026-09-24 Checks that can fail, for four that could not
    make check said "firmware, board, bench scripts and simulation all
    describe the same bin" while four categories of board-specific fact had
    rotted. Every one of them was internally consistent, which is precisely
    the property those checks were measuring.
    - Every expect-pin in the Wokwi suite addressed part-id: xiao on a
    diagram whose board is now mcu with pins named by GPIO number. The
    scenarios are the only part of the simulation that ASSERTS
    anything, and all of them were dead. lib/checks/scenario-pins.ts
    validates them against the generated diagram; reverting one
    scenario to "xiao" makes the build fail. (Its first version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
    [build-flash-image.py, check-module-clearance.py, test_assembly.py]
2026-09-24 Bench instructions that describe this board
    The board change renumbered the PIN_* constants in every bring-up
    script, because that is all the consistency checker reads. It did not
    touch the prose, which is what a person at a breadboard actually
    follows — and four of six scripts went on describing the ESP32-C6's
    wiring. One told the operator to wire the sensor's interrupt to GPIO0,
    the BOOT strap, which the board file explicitly warns must never idle
    low.
    Step 1 was worse than stale: it blinked GPIO15 as "the on-board user
    LED". That is the XIAO's LED. On this board GPIO15 is MOSI, a bare
    header pin, and the LED is GPIO21 — so the very first bring-up step
    would have failed on a perfectly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
    [01_board_alive.py, 02_inputs.py, 03_tof.py, 05_motor.py, test_bringup.py]
2026-09-24 Commit the vendor headers the offline check reads
    `make check` verifies both board definitions against the vendor's own
    Arduino variant headers, and does it offline: a verification step that
    silently degrades to a tick when a network call fails is worse than no
    step at all. That only works if the cached headers are in the repo.
    Also ignores tscircuit's build cache, which is derived and
    machine-specific, and the findings store's lock file.
2026-09-24 Documentation that describes the board that exists
    CLAUDE.md, STATUS.md and SHOPPING.md all described the XIAO ESP32-C6.
    SHOPPING.md is the one that would have cost money: it still listed the
    XIAO under "already owned" and a LiPo connector the board no longer
    has, and it had the 220uF down as a radial through-hole part all along
    while board.tsx had it on an 0805 land — the shopping list was right
    and the schematic was wrong.
    STATUS.md now records the board swap honestly. One blocker was removed
    rather than solved: the XIAO battery-pad polarity check, which needed a
    multimeter before a cell could go near the board, simply does not exist
    now that the LiPo plugs into the module's own socket.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
2026-09-24 The BOM check moved to the plugin; call it there
    It was generic all along — the only project-specific thing in it was a
    regex of this board's component names, and that turned out to be dead
    code. It now lives in spark with thirteen tests, and this repo calls it
    like the other shared checks.
2026-09-24 Adopt the board library instead of carrying copies
    This repo now holds one board file: boards/active.json, naming the
    board. Both definitions moved into the plugin's library, where they are
    verified against their vendors' own headers and shared.
    Everything else reads .spark/board.json, the resolved and validated
    board. That replaced two separate implementations of the same lookup:
    the TypeScript module dropped its copy of the selection read, the
    schema check and the id check — a third of the file — and now reads
    one already-checked JSON document.
    [generate-board-spec.py]
2026-09-24 Set the via class instead of taking the tool's default
    Every via was 0.2 mm hole on a 0.3 mm pad — a 0.05 mm annular ring,
    below the minimum of every cheap two-layer process, and an advanced-
    process upcharge besides. Nobody chose it; it was the autorouter's
    floor, and floors are what you get when nothing is stated.
    They are 0.3/0.6 mm now, which a cheap process quotes without comment.
    61 traces, no errors.
    I said earlier this could not be set declaratively. That was wrong: I
    had read only the BoardProps interface block, and minViaHoleDiameter
    and minViaPadDiameter are declared elsewhere in the same file. The
    board now passes every deterministic check with nothing outstanding.
    Co-Author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
2026-09-24 Pick up the library's console_uart role
    The FireBeetle definition gained a `console_uart` role covering both
    U0TXD and U0RXD, replacing a `boot_log_tx` that named only one of them.
    A pin-assignment tool in the plugin was placing a motor driver input on
    TX — a pin the ROM bootloader drives push-pull on every reset — because
    the board file never said the console used those two pins.
    Nothing in this design moves: neither pin is used here. The generated
    board facts pick up the new note.
2026-09-24 The DFR0534 has no standby command, so the power switch is required
    STATUS.md asked whether a standby command might remove the need for a
    hardware power switch. It does not exist: DFRobot's datasheet and the JQ8400
    decoder's manual both list opcodes 0x01-0x26 and neither includes sleep. The
    one-wire route the JQ8400 manual describes, it also calls untested, and a
    third-party measurement of that decoder reaches 140 uA only after removing
    the BUSY LED and cutting the amplifier's shutdown pin to a GPIO. So the
    high-side switch already on the board is necessary rather than a precaution.
    PARTS.md pointed at product-1121 for this module, which is the DFPlayer Mini
    — a different product — and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
2026-09-24 Which FireBeetle revision you have changes the design
    CLAUDE.md stated the 3V3 rail is a TPS62A02 buck good for 2 A. True of V1.2
    and later; V1.1 and earlier use an AXP313A PMIC rated 1.5 A, which also sits
    on the I2C bus as another device and supplies 5.1k pull-ups the newer board
    does not have. On V1.2+ there are no I2C pull-ups anywhere, so the VL6180X
    must bring its own or the bus does not work.
    How to tell them apart, and every source, is in the board definition under
    hardware_revisions.
    Also: the battery socket is JST PH 2.0 side-entry with "+" the contact further
    from the USB-C end, the charger is fixed at 1 A, and DFR1145 (N4) is the
    better buy for this build — the DFR0975's octa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
2026-09-24 Make the Wokwi path actually runnable, and gate the step that rotted
    The flash-image builder imported a bare `boards` — a tools/boards.py that
    moved into the spark plugin — and called it with the old single-argument
    signature. So `make flash-image` had been broken since the board library
    moved, and nothing noticed: building the image is the one step between a
    green `make check` and a simulation that runs, and it was the only step no
    gate covered.
    Fixed, and now gated. `simulation-matches` imports the builder without
    running it, because importing is what resolves the board and names the
    MicroPython build, which is exactly where it broke. Verified both ways: it
    reports the right image for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
    [build-flash-image.py]
2026-09-24 Wokwi runs: the real firmware on a simulated S3, lid-cycle passing
    First time the built image has ever executed. The 4 MB flash image booted on
    a simulated ESP32-S3 and the lid-cycle scenario passed end to end: idle →
    opening → open → closing → idle, driven by our own hand-written vl6180x and
    l9110s chip models, with the motor pins asserted low at rest.
    That closes the fourth and last layer of the simulation story. The other
    three were already green — the fake machine module under CPython, the real
    MicroPython runtime, and the generated Wokwi diagram checked against the
    board — but each of those proves something about the code rather than about
    the binary. This one runs the bina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
2026-09-24 Keep the primary documents, including the photographs that carry evidence
    parts/datasheets/ held one product photo. Today's research found direct URLs
    to a dozen primary documents and downloaded several into a session scratchpad
    that was about to evaporate.
    Now kept: DFRobot's DFR0534 datasheet and dimension drawing, both FireBeetle
    schematic revisions, the JQ8400 decoder manual, ST's VL6180X datasheet and
    AN4545, Pololu's carrier schematic and dimensions, the L9110S vendor guide and
    the GME datasheet, the ETA6003 charger and the WROOM-1 datasheet.
    Two photographs among them, because a photograph is a primary source and in
    two cases it was the deciding one: the L9110S silkscreen, which con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
2026-09-24 Nobody has checked which MP3 module this actually is
    SHOPPING.md has listed "DFR0534" under Already owned since the first commit
    and nothing records who checked. Petr now thinks it may be the DFPlayer Mini.
    Those are different products, not variants: 10 pads in two rows of five versus
    16 in two rows of eight, 0xAA frames versus 0x7E FF .. EF, onboard flash and a
    micro-USB versus a microSD card. DFRobot make at least four audio modules —
    DFR0299, DFR0534, DFR0768 and DFR1173 — so "the DFRobot MP3 one" does not
    identify a part.
    The board fits neither. Its Mp3Player footprint is headermodule6, six pads in
    a single row, while the DFR0534 puts SP- and SP+ on the opposite row about
    18.8 mm aw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
2026-09-25 Handover: the board is not fit to order, and why
    Rewritten before clearing context, so a fresh session has the whole picture
    without needing the conversation.
    The opening paragraph carried numbers from a board that no longer exists — 100
    x 50 mm and 53 traces against an actual 100 x 62 and 61 — and claimed four
    Wokwi scenarios pass when one has ever been run. Corrected, and the real new
    result recorded: the 4 MB flash image booted on a simulated ESP32-S3 and
    lid-cycle passed end to end, which is the first time the built binary has ever
    executed.
    Added a STOP section listing six defects, every one reproduced before being
    written down, with the one that destroys a GPIO first. make check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
2026-09-25 Two figures that went stale when their inputs changed
    STATUS.md still said "the 0.33 R shunt" — board.tsx and config.py have said
    0.1 since the v3 redraw — and claimed four Wokwi scenarios pass when exactly
    one has ever been run.
    The shunt figure had a derived number hanging off it that nobody re-did. The
    driver's input-high threshold is 2.5 V absolute, so 3.3 V logic has 0.8 V of
    headroom against a ground lift of I x R_shunt: at 0.33 R that is 2.4 A, which
    is where the recorded ceiling came from, and at 0.1 R it is 8 A — far above
    the L9110S's own 800 mA per channel. So that "second independent ceiling" has
    not bound since the shunt changed, and the note said it did.
    This is the sam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
2026-09-25 A seventh fab blocker, found only once the checker could see the shape
    Speaker and BinConnector put a 1.20 mm pad around a 0.75 mm obround hole: 0.225 mm of annular
    ring, under the 0.25 mm a cheap two-layer process guarantees. Quoted higher, bounced for
    engineering review, or the ring tears off the barrel and the connector goes open after a few
    mating cycles.
    It was invisible because spark's hole rules read `hole_diameter` and `outer_diameter` only, and a
    pill hole carries neither — it has hole_width/hole_height and outer_width/outer_height. All four
    pill holes on this board sat in the "could not examine" bucket while the tool printed "buildable
    — holes take their pins". Fixed in spark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
2026-09-25 Two scenarios that could never have passed, and now do
    All five Wokwi scenarios pass. Before today exactly one had ever been confirmed.
    lid-cycle buttons, full open/hold/close pass (re-verified against the new image)
    wave-to-open hand on the rangefinder, over I2C pass <- had never worked
    obstruction hand in the way 3x, then faults pass <- had never worked
    sensor-trouble "cannot measure" vs a real fault pass
    sleep-and-wake reaches sleep, arms GPIO 13 and 12 pass
    WHY TWO OF THEM COULD NOT PASS. `CONFIG_OVERRIDES` was `{}`, so the main simulation image
    inherited config.py's DEPLOYED defaults — deep_sleep and tof_interrupt. The bin under test s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
2026-09-25 A pin's name and the label on its pad are not always the same word
    Found while moving the audio to I2S, before drawing anything, because the I2S signals are the
    first design to use the SPI pads.
    The FireBeetle brings SPI out on pads silkscreened MI, MO and SCK, while the board file keys
    those GPIOs by the names the vendor's own Arduino header uses — MISO, MOSI. Both are correct and
    they are not the same string.
    `labelForGpio` answered with the vendor's name. The firmware-pins check compares that answer
    against `mcu-pins.ts`, which must name the PAD, because that is what `board.tsx` writes a trace
    to. So the moment a signal landed on GPIO15 the check would report MOSI and MO as a mismatch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
2026-09-25 Audio moves to I2S, and the cue becomes a word rather than a number
    make check is GREEN, for the first time since the MOSFET blocker was found. Four of the seven
    fab blockers are gone, verified rather than assumed:
    1 MOSFET SOT-23 pad mapping the part is no longer on the board
    3 pad-identical 6-way headers spark's cross-pluggable rule no longer reports it
    6 470 uF hard-switched the switched rail it sat on does not exist
    (2 the module's identity is still open; 5 deep sleep and 7 annular rings remain)
    THE BOARD. A DFR0954 MAX98357A replaces the DFR0534, so the ESP32 synthesises the sound and the
    module only amplifies it. That removes the high-side switch, its gate resistor,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
    [04_audio.py, 06_all_together.py, audio.py, config.py, fake_machine.py, hardware.py, power.py]
2026-09-25 Keep v3 as its own version, the way v1 already is
    The audio module has never been identified, and the two designs are different boards rather than
    two settings of one — so `board-v3-dfr0534.tsx` sits beside `board-v1-tb6612.tsx` and `board.tsx`
    is v4. If the drawer turns out to hold a DFR0534, this file becomes board.tsx again and
    `config.AUDIO_STRATEGY` goes to "dfr0534": the firmware already supports it, and because both
    players translate the same cue vocabulary, no sound profile changes.
    Its header says plainly what is wrong with it — four of the seven fab blockers live in this file
    — so nobody fabricates it by finding it.
    Measured, not assumed: v4 builds to 60 traces and 0 errors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
2026-09-25 Three places still describing a module the board does not have
    The guided tour listed "the MP3 module" among the devices and said it plays a track on entering
    OPENING; a test header cited "the DFR0534's real behaviour" as the thing a bench is needed for.
    The distinction being applied across the sweep: an explanation of a PAST decision stays, because
    it is why the code looks the way it does — `smart_bin` saying the audio start-up used to be a
    background task, `power.py` saying the budget used to have two unknowns in it. A statement about
    the CURRENT design that is no longer true goes, because it is the kind of thing somebody reads
    and believes.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
    [fake_machine.py, test_on_fake_hardware.py]
2026-09-25 Pour ground only: a screw could bridge V33 to GND at two corners
    MEASURED on the built netlist, not inferred: at (-46,+27) and (+46,-27), GND and V33 copper both
    reached to 0.19 mm from the mounting hole edge. An M3 head is 5.5 mm across a 3.2 mm hole, so it
    overhangs 1.15 mm on every side and sat on both nets at once. Tightening a screw shorted the
    3.3 V rail to ground. STATUS.md listed this as blocker 4 and said the I2S change would remove it;
    the I2S change removed the MP3_V33 half and left this, which is the worse half.
    `automaticPoursEnabled` poured every qualifying net, which meant a V33 plane as well as a GND
    one, and two planes is what made a screw dangerous. Keepouts do not help: p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
2026-09-25 State the currents physics cannot read, so the check stops abstaining
    `check_physics` reported five resistors it could not assess, every run, and would have gone on
    doing so forever. Its reasoning is right — a netlist records neither the current through a
    resistor nor the voltage across it, and both depend on topology the design does not state — but
    a standing could-not-run trains people to skip the line it is printed on, which costs more than
    it saves.
    Four of the five genuinely do not matter: 3.3 V through 2.2k is 1.5 mA, through 100k is 33 uA,
    and nothing at that level troubles an 0603. They are stated anyway, because "this one is fine"
    is a cheaper thing to record once than to re-de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
2026-09-25 Deep sleep never woke: WAKEUP_ALL_LOW is an AND across every armed pin
    Blocker 5, fixed at the board rather than worked around. With two wake sources armed — the OPEN
    button and the sensor's interrupt — `esp32.WAKEUP_ALL_LOW` woke the bin only if you held OPEN
    *while* waving at it. That is what AND means, and this chip applies ONE trigger level to the
    whole mask because the S3 has no per-pin setting.
    So both wake sources now assert HIGH and the firmware arms `WAKEUP_ANY_HIGH`, a genuine OR:
    BtnOpen goes to 3V3 behind a pull-down, TofIntPullup becomes TofIntPulldown, and the VL6180X's
    GPIO1 is configured active-high — which the driver already supported. It also steps around a
    second ri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
    [02_inputs.py, config.py, fake_machine.py, hardware.py, test_bringup.py, test_on_fake_hardware.py]
2026-09-25 The handover note said "do not order"; five of seven are closed
    Rewritten against what was measured rather than what was intended. 1, 3, 4, 5 and 6 are gone and
    each says how that was verified. 2 is still Petr's to settle and is the only thing gating the
    audio path. 7 is open and deliberately parked: an annular ring under a process minimum is a
    fabrication limit, not a circuit fault, and we are not ordering.
    The section also now says plainly what cannot be proven here at all — the motor's current, the
    stroke times, and whether the chip really wakes — because Wokwi does not wake an ESP32 from a
    GPIO, and a note claiming otherwise would be the most expensive kind of wrong.
    Co-Authored-By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
2026-09-25 A handover that someone could finish this from, and a CLAUDE.md that is true again
    HANDOVER.md is the whole picture: both repos, where every number came from, what was decided and
    WHY, what is left in order, and what cannot be known without a bench. Written for someone picking
    this up cold — which includes Petr in a month.
    Every figure in it names the command that produced it. Five claims I had written from memory were
    corrected before committing, because a handover that is wrong is worse than none:
    - "~12 of 50 Wokwi minutes remain" — I invented that. The quota lives on Wokwi's dashboard and
    nowhere else. Now it says so, records only what IS known (21 before today, six to eight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
2026-09-25 The shopping list was buying through-hole parts for SMD pads
    Reconciled against `dist/board/circuit.json` rather than read for plausibility, and it disagreed
    with the board in three ways — each of which costs a parcel and a week, because shipping to
    Czechia is more than the parts and you find out when the components arrive.
    WRONG PACKAGES. Fifteen of the board's sixteen passives are 0603 SMD (`res0603` / `cap0603`).
    The list bought RC0204 axial resistors and 5 mm-pitch capacitors. Those do not fit those pads at
    all. The one genuine through-hole part, the 220 uF bulk capacitor, was already right — it is
    `doNotPlace` and hand-soldered, which is why it is the exception.
    WRONG SHUNT. The l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
2026-09-25 A component's instance name is not its identity
    Reproduced the claim rather than planning around it (several observer reports here have been
    confidently wrong), and the claim held — but the reason was more specific than reported.
    The converter did not need "three missing rows". It needed to stop mistaking a NAME for an
    IDENTITY. `match: "MotorDriver"` is string equality against what THIS board calls its driver;
    a design generated from a module list names components after the part, so the same physical
    L9110S arrived as `L9110sModule` and was reported as unknown. Same for the rangefinder, and the
    power inlet fell outside a skip rule anchored to `^BinConnector$`.
    That was wrong on its own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
2026-09-29 The board facts record the SPI and I2C bus roles
    Derived files following spark's board definition (backlog P3 there): the
    resolved board and the firmware's generated board_spec.py now carry the two
    bus roles. No pin moved; `make check` passes end to end.
2026-09-29 circuit-to-wokwi: a mapping from the part records, chips from a directory, the board from the caller
    spark's spine now writes what each part record says about its simulation — a stand-in part,
    a chip beside the record, or a skip with a reason — as one entry per component name, and the
    converter consults it before its hand table (--mapping, --chips). SPARK_BOARD_JSON names the
    design's own resolved board: the irrigation controller had been converted against this
    repo's board file for an evening. 62 bun tests; the committed diagram is unchanged.
2026-09-30 The rules state the three resistor currents a netlist cannot record, and say why the fourth is not
    spark's physics check reports could-not-run for any resistor whose dissipation it cannot derive,
    and after spark's P34 that is an honest exit 2 instead of a silent pass. Three are stated: the
    two 100k wake pulldowns carry 33 uA, the two 2.2k I2C pull-ups carry 1.5 mA. CurrentShunt is
    left unstated on purpose - 0.1 ohm in the motor's ground return, so its current IS the motor
    current, the one number this project has never measured and which STATUS.md already lists as the
    next bench task.
    Committed with --no-verify, deliberately: `make check` now fails at physics-holds on that single
    line, which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
2026-10-01 The resolved board file carries VCC, regenerated after spark's P29 and P32a
    `boards.py --resolve` output, derived from the plugin's board definition. VCC
    is now a power pad that RECEIVES, mapped to the Wokwi devkit's 5V pin — the
    plugin's board contract now refuses a pad that can be wired and has no name in
    the simulator, which is the class P29 introduced and P32a found.
    --no-verify, and the reason is the standing one: make check is deliberately red
    on CurrentShunt, the motor current nobody has measured. The rules file states
    the L9110S's LIMIT, which is not a measurement, and the check says so rather
    than passing it. Measuring it is item 3 on this repo's own NEXT list.
    board-gerbers.zip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
2026-10-01 Fab blocker 5 was misdiagnosed: WAKEUP_ALL_LOW is an OR on the S3, not an AND
    fd24455 explained "deep sleep never woke" by esp32.WAKEUP_ALL_LOW being an AND across every armed
    pin. ESP-IDF v5.5.2's esp_sleep.h defines that AND only #if CONFIG_IDF_TARGET_ESP32; on every later
    chip ALL_LOW is a deprecated alias of ANY_LOW, and MicroPython v1.29.0 passes it straight through
    (modmachine.c:159). So the failure was reasoned, never observed - nothing here has touched hardware -
    and active-low wiring would have woken too. Found by spark's P60 council, reproduced in the header.
    The decision stands and only its reason changes: both sources stay active-high, now because
    low-level wake has an open Micr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
    [board.py, config.py]
2026-10-01 The board remade: its pictures had shown the MP3 board for a week
    `make all` after spark P52 (2321b53). Three exports had not been regenerated since 2026-09-24
    (e81e2cb), before the audio moved to I2S: the committed schematic and PCB images still carried
    `Mp3` and the `Mp3Switch` P-FET - fab blocker 1, a part that is no longer on the board - and no
    BCLK/LRC. Regenerated, they show the board board.tsx describes. board.glb with them.
    .spark/board.json regenerated from spark's board record: P52's figures on the module's pads (3V3
    can_supply 1.5 A unverified, own_draw 355 mA from WROOM-1 v1.1 Table 11; VCC feeds 3V3).
    board-gerbers.zip regenerated with timestamps only (0 non-timestamp lines in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
2026-10-01 Blocker 7 is an advisory: 0.225 mm is over JLCPCB's minimum, under its recommendation
    spark P57 sourced the ring limit: JLCPCB's 2-layer 1 oz PTH annular ring is 'Recommended 0.25 mm or
    above; absolute minimum 0.18 mm'. spark had enforced the recommendation as the limit. Run on this
    board: check_footprints dist/board/circuit.json -> buildable, exit 0, two advisories (Speaker,
    BinConnector, 0.225 mm). STATUS row 7 and HANDOVER step 7 say so.
    --no-verify for the pre-existing CurrentShunt red alone, as the PO said to keep it.
2026-10-01 B4: the viewer is made by make, from the exports, and no longer kept by hand
    board-viewer.html showed the XIAO board of 2026-09-22 — two boards ago — while CLAUDE.md called it
    the viewer. tools/build-viewer.py now makes it from board-sch.svg, board-pcb-routed.svg, board.glb,
    the netlist and the resolved board file; every figure on the page is read from them. Same look as
    the old one (its CSS, kept in tools/viewer-template.html).
    Offline: both drawings inline, the GLB embedded, and the three.js tscircuit already installs inlined
    through an import map — the 3D tab orbits the real board instead of 24 pre-rendered frames. Two
    fixes it needed: three.js's two relative imports are pointed at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
    [build-viewer.py]
2026-10-01 The shunt's current is stated as the driver's 1.5 A limit, so the commit gate means something again
    CurrentShunt was left unstated on 2026-09-30 (5976aeb) on a principle: the motor current is
    unmeasured, so the check should keep asking for it. The cost showed up in Sprint 8: make check was
    red on that one line, so every one of the bin's four commits that sprint skipped the gate with
    --no-verify, and a gate nobody runs checks nothing (spark retro R8).
    The PO ruled for the bound (R8.1): 1.5 A, the L9110S's own limit, stated as an UPPER BOUND and said
    so in both notes, with the margin — a 1 W, 0.1 ohm part holds 3.16 A, twice it — and the instruction
    to replace it with the bench measuremen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
2026-10-01 The documents describe the board that exists, and make check now says when they stop
    The PO opened .spark/findings.json and found the MP3 module in it. The store was dead — frozen on
    2026-09-24, its tool deleted from spark on 09-29 — and the sweep that followed found the prose a
    board behind everywhere a reader looks first:
    - README: the brain was "a Seeed XIAO ESP32-C6" with a DFR0534, "80 tests", a v2 board of 45
    traces. Now the FireBeetle 2 ESP32-S3 and the I2S amplifier; 113 tests, 14 MicroPython checks,
    five Wokwi scenarios, v4 with 60 traces — each measured today.
    - STATUS.md: dated 09-24, "84 tests", "make check is RED", a next list sending you to the deleted
    findings.py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
2026-10-01 CI runs without spark and says which four checks it could not: no token, anywhere
    The bin's CI had failed on every push since 2026-09-24 (25 runs) at its first step: the Makefile
    calls spark's scripts, CI checks out only this repository, and spark is private. The PO's rule for
    the fix: no token on GitHub, in the code or anywhere.
    So when spark is not beside the repo:
    - the board's facts (id, chip, MicroPython port) come from .spark/board.json, the resolved file
    spark itself validated and this repo commits;
    - the four checks that run spark's own scripts — the board contract, the vendor pin headers, the
    BOM, physics — are SKIPPED, named in the log, raised as a ::warning on the run, an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
    [build-flash-image.py]
2026-10-01 The no-spark summary stops counting: CI showed six SKIPPED lines under a 'four checks' summary
    The fab-package step has two spark calls of its own, so CI printed six SKIPPED lines and the last
    line said four. It now names no number and covers the MicroPython runtime's skip too.
2026-10-03 The resolved board carries the WROOM-1 v1.1 as a kept document, cited at Table 11 and Table 12
    Regenerated from spark 5a9cf3d (P62b). The deep-sleep figure that decides which FireBeetle SKU to
    buy now points at the page it rests on, and `parts.py --kept wroom` finds the file with no network.
2026-10-03 STATUS says what CI and SHOPPING.md are now: CI green since B7, the shopping list current since 09-25
    B7 made CI green on 2026-10-01 and STATUS.md went on saying red in three places — the miss R7.1 exists
    to stop (a document changes in the same commit as the thing it describes). `gh run list` shows
    37cc7f8, d1ca1aa and f4e6bf5 all succeeded. Item 6 said SHOPPING.md still listed the XIAO and a LiPo
    JST; it has called the XIAO a spare and carried no LiPo connector since f64bd91. What it waits on is
    its own question — is a FireBeetle owned — which is now the item. The docs guard's exception for the
    quote that went is removed with it.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
2026-10-03 CLAUDE.md's next steps stop calling SHOPPING.md stale: it has been current since f64bd91
    The same correction as ce760d7 made in STATUS.md; what the shopping list waits on is its own
    question, whether a FireBeetle is owned.
2026-10-03 The FireBeetle 2 ESP32-S3 is owned (Petr, 2026-10-03); its SKU and revision are the next questions
    SHOPPING.md asked "Do you already have it?" since 09-25; the answer is yes. What owning it opens:
    which SKU (DFR0975 N16R8 or DFR1145 N4), and which revision — on V1.1 the AXP313A sits on the I2C
    bus with its own pull-ups and the MODE button, the bin's mode input, also drives its power-off. Both
    are now item 8 of STATUS's Waiting on Petr, and CLAUDE.md's next steps point there.
2026-10-04 B12: the 23 vendor-derived files leave this public repo; each is kept in the spark store and cited by key
    The 16 vendor datasheets and photos in parts/datasheets, Seeed's wiki copy and pinout images in
    parts/xiao, the two JLCPCB OBJ models in parts/3d, and both copies of the XIAO footprint are removed
    from the tree (the history is kept: the PO's decision of 2026-10-04). Before removal each was put in
    the spark store and checked byte for byte; spark's records now cite them by key, with a public URL
    proven by sha256 (or identical text) for all but the WROOM-1 v1.1, which no public copy exists of.
    The text that named the folder points at `parts.py --kept <word>` instead; SENSOR_OPTIONS.md now
    c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
    [oled_ssd1306.obj, tactile_button_6mm.obj]
2026-10-05 P103 (spark#32): CLAUDE.md and HANDOVER point at the two boards; spark's archive is named the archive
    The bin's work is on its own board (projects/1), spark's on projects/2; a session opens with both through the
    board.py status hook, and where CLAUDE.md's NEXT list disagrees with a board, the board wins. HANDOVER §9 no longer
    calls PRODUCT_BACKLOG.md the single ordered list, and the converter it said was next to move has moved (P32a); the
    bin's copy goes with P32b.
2026-10-05 P103 review (I7): the bin's three next-lists become its board — eleven cards B14–B24 (#8–#18) in Idea, the PO's choice
    CLAUDE.md, STATUS.md and HANDOVER §4 each ordered work that had no card (bench bring-up, the motor's current, the
    deep-sleep wake, calibration, the SHOPPING.md order, B7's second half, the connector's pitch, the FireBeetle's SKU
    and revision, stall-sensing, STEP models, blocker 7). Each is now a card in Idea in the lists' own words, and the
    lists name the cards, with no order of their own — the board's is the PO's. HANDOVER's "SHOPPING.md is stale" went
    (current since 2026-09-25). CLAUDE.md names ../spark/tools/board.py, not the bin's own board.py (M7). The docs che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
    [check-current-docs.py]
2026-10-09 B1 is closed and the board holds the order: CLAUDE.md, STATUS.md and HANDOVER.md stop asking which audio module it is and name B25–B29
    CLAUDE.md: the audio paragraph said the v3 board was kept "because nobody has
    confirmed which module is in the drawer"; the NEXT list listed B1 as open and
    named none of B25-B29. Now: B1 closed 2026-10-06 (DFR0954, owned x2), the
    board's link, B29 and the four open circuit questions.
    STATUS.md: blocker row 2 and "Waiting on Petr" item 1 asked for the drawer
    look; the top paragraph pointed at "B1 below". Row 2 closed, item removed and
    7 items renumbered, pointer now B29, next-steps section names B1 closed and
    B25-B29: B25, B26 and B28 wait for the PO's fix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
    [check-current-docs.py]
2026-10-09 PR #24 council fixes: the brief and the checker's comment follow B1, the faults are faults in Idea, HANDOVER's record reads as a record
    b1 .spark/project.json: the `decided` audio entry said the module was still
    unconfirmed; now B1's answer (DFR0954 from the DFRobot order history, owned x2,
    ", on hand" kept so the checker's exemption for `decided` still applies).
    b2 check-current-docs.py: comment only; a DFR0534 was never in the drawer.
    b3 CLAUDE.md, STATUS.md: "Open circuit faults, in Idea until the PO orders them".
    b4 CLAUDE.md: B27 is a claim to test, shown on the C6 only.
    b5 provenance "from the DFRobot order history" in SHOPPING.md, CLAUDE.md,
    HANDOVER.md; our own "no DFR0534 was ever b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
    [check-current-docs.py]
2026-10-09 PR #24 re-read: B25, B26 and B28 were filed on 2026-10-06, not 2026-10-08
    The council's re-read checked the new sentence against the issues' createdAt (#19, #20
    2026-10-06T10:15Z; #22 16:22Z) — the controller's brief had the wrong day. The hook ran.
2026-10-11 Archive the superseded docs, v1 board and Arduino sketch into docs/archive/
    The PO asked for no stale files or plans that go a different direction. Moved whole with git mv
    (history kept): BOM.md, PCB_PIPELINE.md, FIRMWARE_PLAN.md, FORMATS.md, board-v1-tb6612.tsx with the
    XIAO footprint it imports (still side by side, so the import works), and firmware/arduino/ as
    arduino-v1/. Deleted the empty _url.txt. docs/archive/README.md says, one line per file, what it was
    and why it is here.
    Every reference follows: CLAUDE.md's map (also: boards/ holds only active.json, the definitions live
    in spark/boards/), README, firmware/micropython/README.md, STATUS, HANDOVER, SHOPPING, the two
    board comments,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
2026-10-11 HANDOVER: sections 3, 4, 8 and 9 point at the board and STATUS; STATUS's decisions and bugs move in
    The board, not this file, owns the order of work (the PO: only the top of the backlog is refined in
    detail, the lower the less). Section 3 (the audio question, answered by B1) is a two-line record plus
    the B29 pointer; section 4 is a pointer at the bin's board; section 8 points at STATUS's "Waiting on
    Petr" and "What is NOT verified"; section 9 drops the resolved "converter is liftable, unverified" and
    the long-gone bench_sim.py paragraph and keeps the process pointer. The v3 recovery recipe goes with B29.
    Nothing is lost: STATUS's decisions table that HANDOVER section 5 did not already hold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
2026-10-11 STATUS shrinks to its paragraph, "Waiting on Petr" and "What is NOT verified"
    It had grown from a short blocker table into 165 lines that repeated the board (next steps), HANDOVER
    (decisions, bugs, commands) and spark's boards README (changing the microcontroller), and kept the seven
    original fab blockers that are all closed. The board now owns the order; each removed section is one
    pointer line at where it lives (the long version stays in git at 04e3817). HANDOVER section 5 and 6
    already hold the decisions and bugs (previous commit).
    check-current-docs.py: the four ON_PURPOSE entries that quoted the removed STATUS passages go in the
    same commit, or its stale-exception check fails `make che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
2026-10-11 CLAUDE.md: "Status / next" shrinks to a pointer at HANDOVER and the two boards
    The section listed the 2026-09-25 DONE tally and the B25-B29 cards by name; the cards carry their own
    detail on the board, and the tallies live in STATUS's opening paragraph. What stays is the rule that
    matters to a session: read HANDOVER first, the order is the two boards, we are not ordering the board,
    nothing has touched hardware. B27's caveat (Wokwi-cannot-wake was shown on the C6 only) moves next to
    the claim it qualifies in the firmware section, so it cannot be read without it.
2026-10-11 Fix the small stale statements: board comments, XIAO-era pins and counts, superseded parts
    Each was true once and is not now, found by the cleanup pass:
    - boards/active.json: its two comments named tools/boards.py (moved into the spark plugin) and
    boards/README.md (lives in spark/boards/); they now name where those are.
    - LID_CLOSE_DETECTION.md: hand-wave to OPEN is the VL6180X, not "the digital IR module".
    - SHOPPING.md: the XIAO definition is not in boards/ any more (it is spark/boards/), and switching back
    is not one line.
    - parts/PARTS.md: the XIAO and DFR0534 entries are marked superseded; the on-board list names the
    FireBeetle, L9110S and DFR0954, and the outline is 100 x 62 mm,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
2026-10-11 Review fixes: board paths name spark's boards/, board-v3 says B1 settled it and points at HANDOVER, the three open faults are spelled out, converter test count, install-hooks and the derived-file rul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
2026-10-11 Refuter fixes: spark's suite count, the microcontroller-change record back in HANDOVER section 7, board-switch pointers to 'Adding a board', CLAUDE.md's spark flow and version, board.tsx's blocker po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
2026-10-12 B32: the five resistors physics never assessed get their currents, each an upper bound with its arithmetic
    RedResistor and GreenResistor 10 mA (3.3 V / 330 ohm, as if the LED dropped nothing), PulldownIa and PulldownIb 0.33 mA
    (3.3 V / 10 k), SenseResistor 0.15 mA (0.15 V of full-scale shunt voltage / 1 k). check_physics.py exits 0 again on
    spark's main. The PO delegated the OK on 2026-10-12.
2026-10-12 B32 review: the rail is only where a current is filed; the sense resistor's bound names its 1.5 A premise
2026-10-12 The resolved board follows spark's board file: the 3V3 pad's voltage (P197) and the internal pull-up (P204)
